solar-pwr/usb-pmt/production/bom-for-jlcpcb.xls

Comment | Designator | Footprint | JLCPCB Part # | Qty | Ext.Price($)
TL431DBZ | U2 | SOT-23 | C6971 | 5 | 0.82
1uF | C22 | 0805 | C28323 | 5 | 0.15
4.7nF/2kV | C1,C2,C3,C9 | 1812 | C309511 | 22 | 3.72
MMBT2222A | Q2,Q3 | SOT-23 | C8512 | 10 | 0.18
1R | R32 | 0603 | C22936 | 5 | 0.01
CM108B | IC1 | LQFP-48_7x7mm_P0.5mm | C371347 | 5 | 17.91
10M/200V | R10,R11,R12,R3,R4,R5,R6,R7,R8,R9 | 1206 | C26119 | 54 | 0.30
100pF | C23,C24 | 0603 | C14858 | 10 | 0.09
PWR | D8 | 0805 | C84256 | 5 | 0.07
22k | R24,R25 | 0603 | C31850 | 10 | 0.04
LEDO | D7 | 0805 | C2297 | 5 | 0.08
82k | R14 | 0603 | C23254 | 5 | 0.01
10uF | C19 | 0603 | C19702 | 5 | 0.14
LM393 | U3 | SOIC-8_3.9x4.9mm_P1.27mm | C7955 | 5 | 0.33
10uF | C14,C15,C16,C17,C18,C20,C25,C28 | 0805 | C15850 | 40 | 1.70
US1M | D1,D2,D3,D4 | D_SMA | C412437 | 20 | 0.27
22R | R34,R35 | 0603 | C23345 | 10 | 0.02
47nF/2kV | C6,C8 | 2225 | C2936147 | 10 | 4.79
5k1 | R15,R39,R40 | 0603 | C23186 | 15 | 0.02
1R | R30,R31 | 1206 | C17928 | 10 | 0.23
IPN80R2K0P7 | Q1 | SOT-223-3_TabPin2 | C537101 | 5 | 1.91
1M/200V | R19,R20,R21,R22,R23 | 1206 | C17927 | 25 | 0.11
51k | R17,R18 | 0603 | C23196 | 10 | 0.02
100nF | C13,C21,C26,C27 | 0805 | C28233 | 20 | 0.49
150pF | C10 | 0603 | C1594 | 5 | 0.03
330pF | C4 | 0603 | C1664 | 5 | 0.09
USB-C | J2 | USB_C_Receptacle_GCT_USB4105-xx-A_16P_TopMnt_Horizontal | C5150972 | 5 | 3.70
1M | R26 | 0603 | C22935 | 5 | 0.01
1N4148W | D5 | D_SOD-123 | C81598 | 5 | 0.06
10k | R27 | 0603 | C25804 | 5 | 0.01
1k | R2,R28,R29 | 0603 | C21190 | 15 | 0.03
LEDR | D6 | 0805 | C34499 | 5 | 0.10
100k | R13,R16 | 0603 | C25803 | 10 | 0.03
100nF | C5 | 0603 | C14663 | 5 | 0.04
470k | R1 | 0603 | C23178 | 5 | 0.02
4.7nF | C11,C12 | 0603 | C53987 | 10 | 0.06
2k2 | R36,R37,R38 | 0603 | C4190 | 15 | 0.03
74HC14 | U1 | SOIC-14_3.9x8.7mm_P1.27mm | C5605 | 5 | 0.39
