solar-pwr/usb-pmt/production/bom.csv

Designator | Footprint | Quantity | Value | LCSC Part #
C1, C2, C3, C9 | 1812 | 4 | 4.7nF/2kV
C10 | 0603 | 1 | 150pF
C11, C12 | 0603 | 2 | 4.7nF
C13, C21, C26, C27 | 0805 | 4 | 100nF
C14, C15, C16, C17, C20, C25 | 0805 | 6 | 10uF
C18, C28 | 0805 | 2 | 22uF | CL21A226MAQNNNE
C19 | 0603 | 1 | 10uF
C22 | 0805 | 1 | 1uF
C23, C24 | 0603 | 2 | 100pF
C29, C7 | CP_Radial_D8.0mm_P3.50mm | 2 | 1mF/16V
C4 | 0603 | 1 | 330pF
C5 | 0603 | 1 | 100nF
C6, C8 | 2225 | 2 | 47nF/2kV
D1, D2, D3, D4 | D_SMA | 4 | US1M
D5 | D_SOD-123 | 1 | 1N4148W
D6 | 0805 | 1 | LEDR
D7 | 0805 | 1 | LEDO
D8 | 0805 | 1 | PWR
IC1 | LQFP-48_7x7mm_P0.5mm | 1 | CM108B
J1 | LEMO-EPL.00.250.NTN+RSMA | 1 | LEMO/RSMA
J2 | USB_C_Receptacle_GCT_USB4105-xx-A_16P_TopMnt_Horizontal | 1 | USB-C
L1 | L_Radial_D12.0mm_P5.00mm_Fastron_11P | 1 | 3.3mH
L2 | L_Radial_D12.0mm_P5.00mm_Fastron_11P | 1 | 1mH
Q1 | SOT-223-3_TabPin2 | 1 | IPN80R2K0P7
Q2, Q3 | SOT-23 | 2 | MMBT2222A
R1 | 0603 | 1 | 470k
R10, R11, R12, R3, R4, R5, R6, R7, R8, R9 | 1206 | 10 | 10M/200V
R13, R16 | 0603 | 2 | 100k
R14 | 0603 | 1 | 82k
R15, R39, R40 | 0603 | 3 | 5k1
R17, R18 | 0603 | 2 | 51k
R19, R20, R21, R22, R23 | 1206 | 5 | 1M/200V
R2, R28, R29 | 0603 | 3 | 1k
R24, R25 | 0603 | 2 | 22k
R26 | 0603 | 1 | 1M
R27 | 0603 | 1 | 10k
R30, R31 | 1206 | 2 | 1R
R32 | 0603 | 1 | 1R
R34, R35 | 0603 | 2 | 22R
R36, R37, R38 | 0603 | 3 | 2k2
RV1 | Potentiometer_Bourns_3006P_Horizontal | 1 | 500k
TP1 | PinHeader_1x01_P2.54mm_Vertical | 1 | PMT+
TP2 | PinHeader_1x01_P2.54mm_Vertical | 1 | PMT-
U1 | SOIC-14_3.9x8.7mm_P1.27mm | 1 | 74HC14
U2 | SOT-23 | 1 | TL431DBZ
U3 | SOIC-8_3.9x4.9mm_P1.27mm | 1 | LM393
U4 | DIP-8_W7.62mm_Socket_LongPads | 1 | 93C46B
