solar-pwr/usb-pmt/usb-pmt.pdf

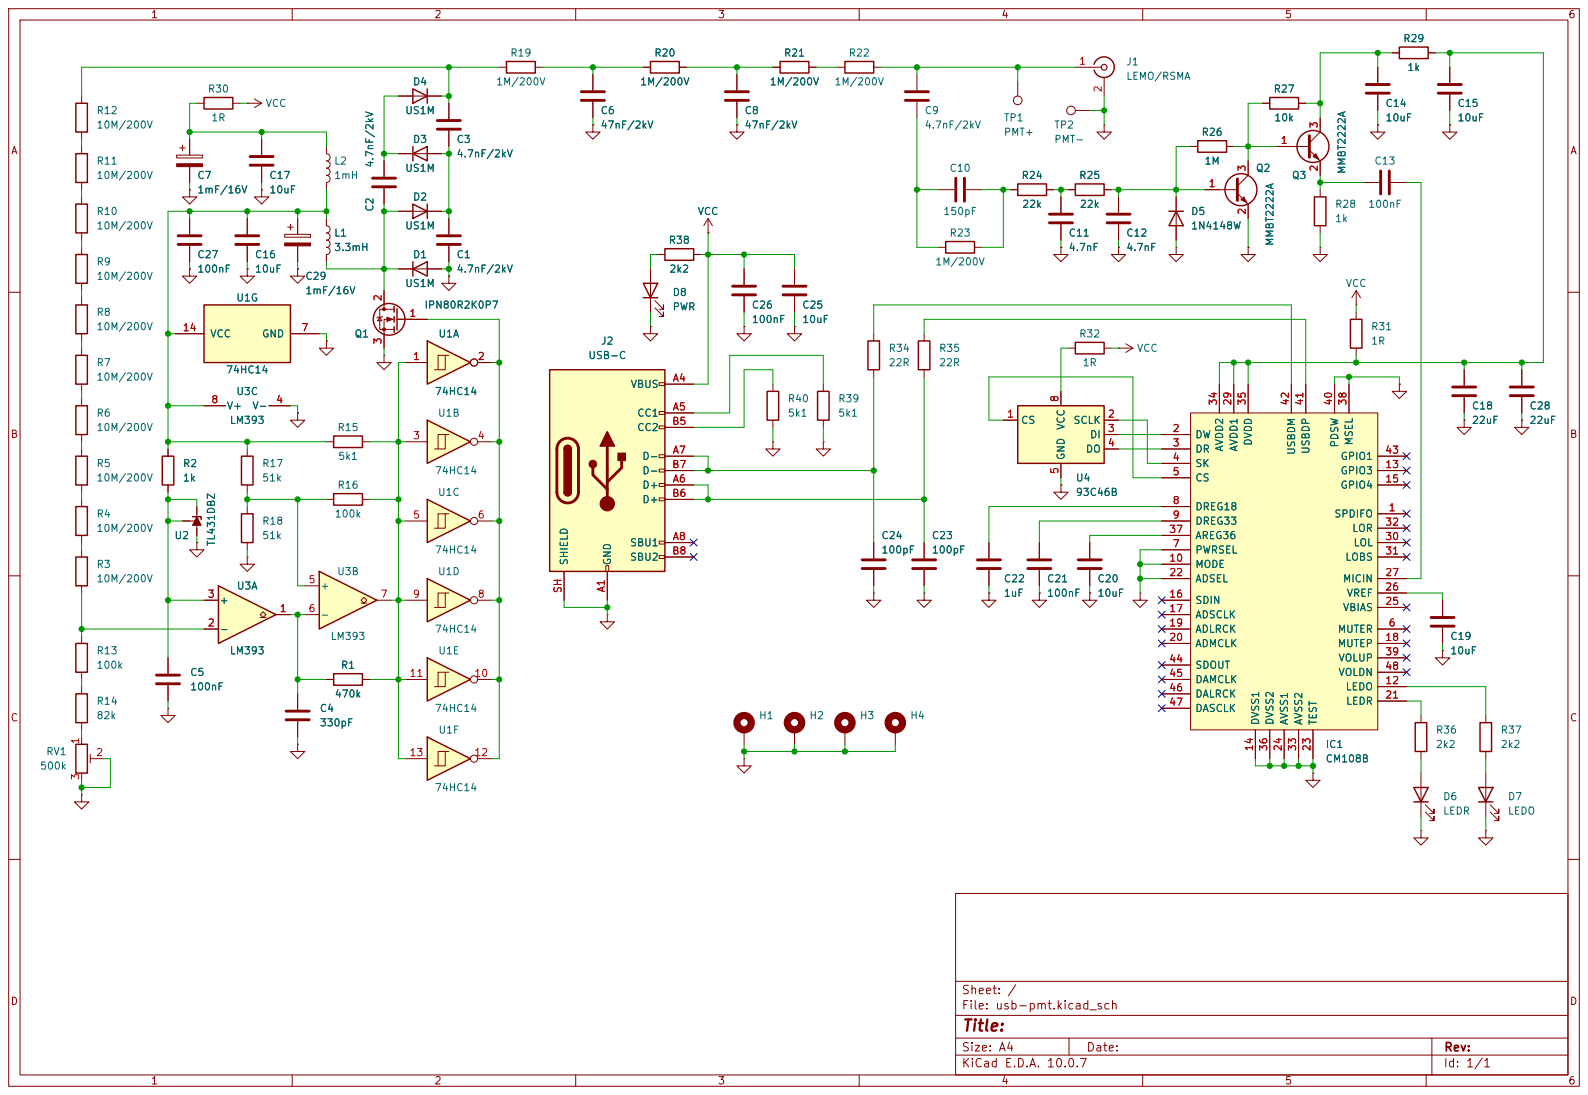
[picture p1: page 1]

Size: A4 | Rev:
KiCad E.D.A. 10.0.7 | Id: 1/1
