solar-pwr/usb-pmt/usb-pmt.kicad_pcb

## KiCad design usb-pmt.kicad_pcb (2026-10-22)

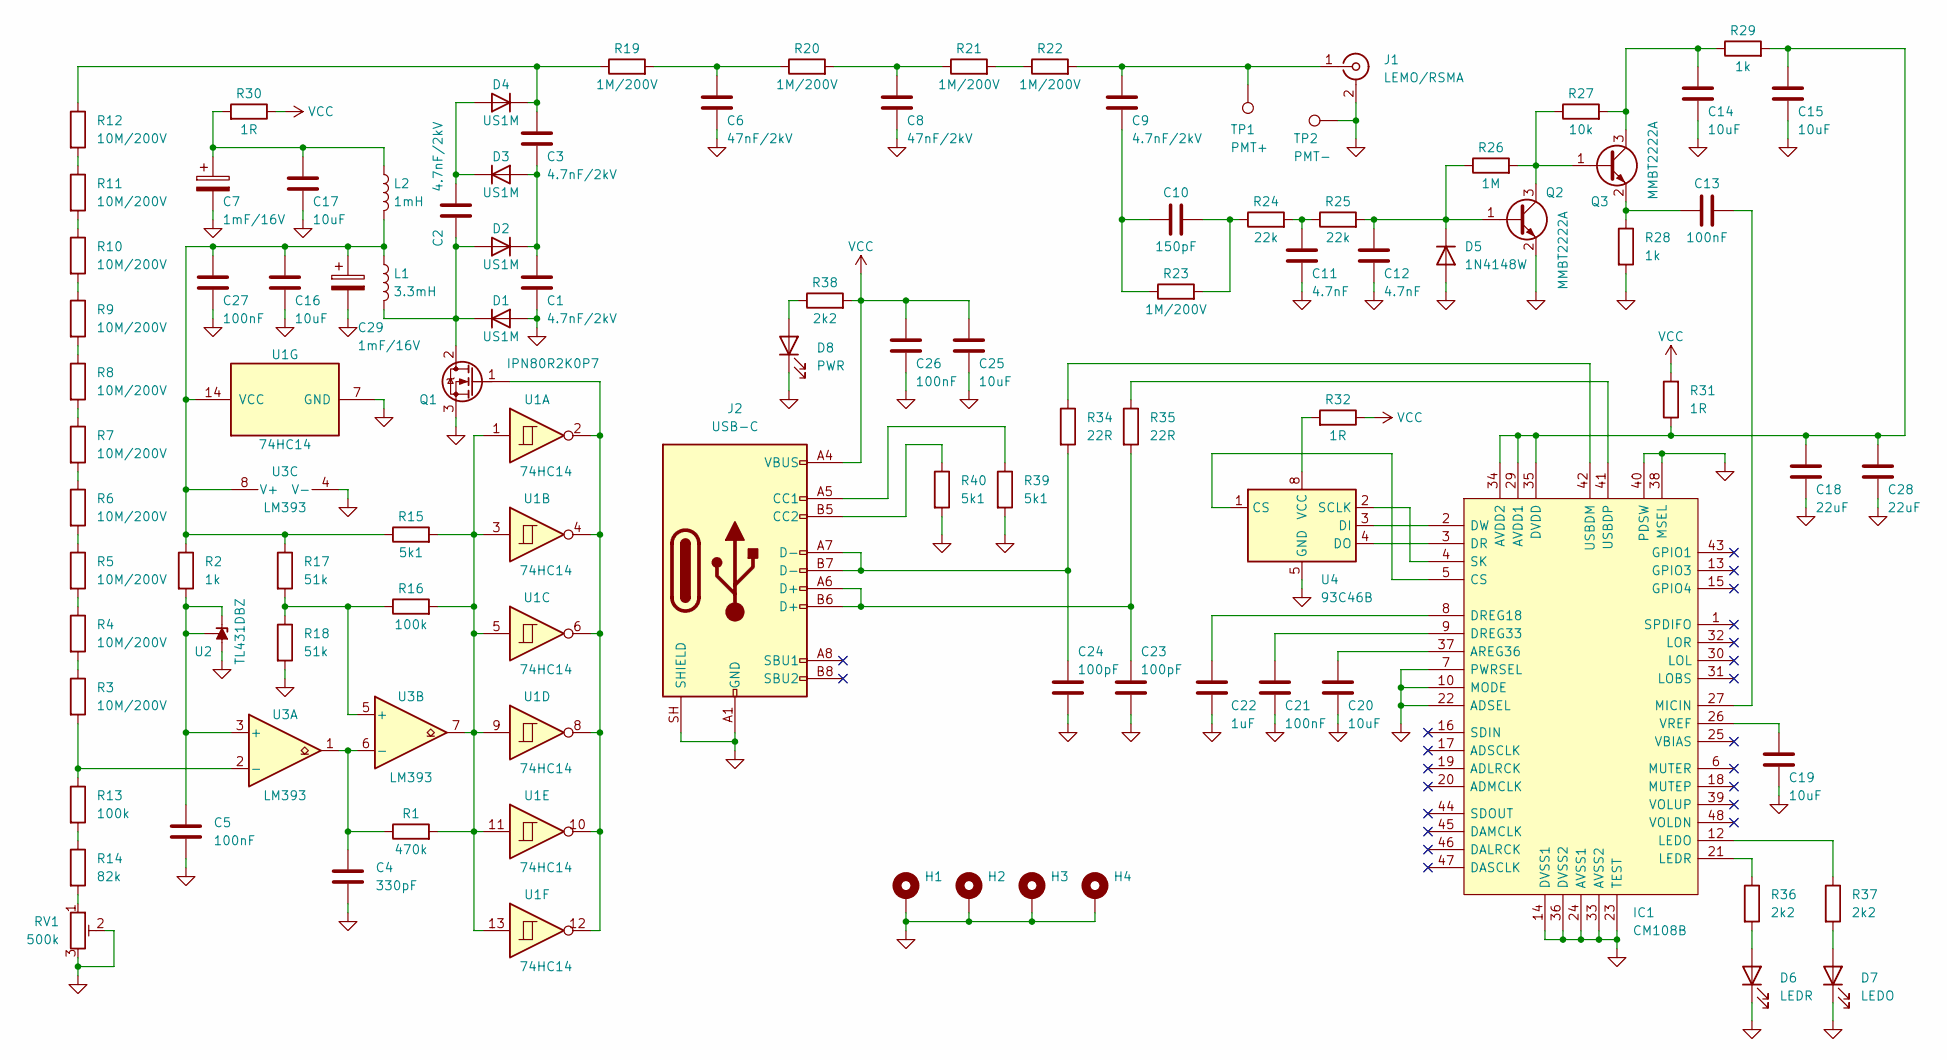
[picture p2: schematic usb-pmt.kicad_sch]

Parts:
C1, C2, C3, C9: 4.7nF/2kV; C_1812_4532Metric
C4: 330pF; C_0603_1608Metric
C5: 100nF; C_0603_1608Metric
C6, C8: 47nF/2kV; C_2225_5664Metric
C7, C29: 1mF/16V; CP_Radial_D8.0mm_P3.50mm
C10: 150pF; C_0603_1608Metric
C11, C12: 4.7nF; C_0603_1608Metric
C13, C21, C26, C27: 100nF; C_0805_2012Metric
C14, C15, C16, C17, C20, C25: 10uF; C_0805_2012Metric
C18, C28: 22uF; C_0805_2012Metric; LCSC CL21A226MAQNNNE
C19: 10uF; C_0603_1608Metric
C22: 1uF; C_0805_2012Metric
C23, C24: 100pF; C_0603_1608Metric
D1, D2, D3, D4: US1M; D_SMA
D5: 1N4148W; D_SOD-123
D6: LEDR; LED_0805_2012Metric
D7: LEDO; LED_0805_2012Metric
D8: PWR; LED_0805_2012Metric
H1, H2, H3, H4: MountingHole_Pad; MountingHole_3.2mm_M3_DIN965_Pad
IC1: CM108B; LQFP-48_7x7mm_P0.5mm; Manufacturer_Part_Number CM108
J1: LEMO/RSMA; LEMO-EPL.00.250.NTN+RSMA
J2: USB-C; USB_C_Receptacle_GCT_USB4105-xx-A_16P_TopMnt_Horizontal
L1: 3.3mH; L_Radial_D12.0mm_P5.00mm_Fastron_11P
L2: 1mH; L_Radial_D12.0mm_P5.00mm_Fastron_11P
Q1: IPN80R2K0P7; SOT-223-3_TabPin2
Q2, Q3: MMBT2222A; SOT-23
R1: 470k; R_0603_1608Metric
R2, R28, R29: 1k; R_0603_1608Metric
R3, R4, R5, R6, R7, R8, R9, R10, R11, R12: 10M/200V; R_1206_3216Metric
R13, R16: 100k; R_0603_1608Metric
R14: 82k; R_0603_1608Metric
R15, R39, R40: 5k1; R_0603_1608Metric
R17, R18: 51k; R_0603_1608Metric
R19, R20, R21, R22, R23: 1M/200V; R_1206_3216Metric
R24, R25: 22k; R_0603_1608Metric
R26: 1M; R_0603_1608Metric
R27: 10k; R_0603_1608Metric
R30, R31: 1R; R_1206_3216Metric
R32: 1R; R_0603_1608Metric
R34, R35: 22R; R_0603_1608Metric
R36, R37, R38: 2k2; R_0603_1608Metric
RV1: 500k; Potentiometer_Bourns_3006P_Horizontal
TP1: PMT+; PinHeader_1x01_P2.54mm_Vertical
TP2: PMT-; PinHeader_1x01_P2.54mm_Vertical
U1: 74HC14; SOIC-14_3.9x8.7mm_P1.27mm
U2: TL431DBZ; SOT-23
U3: LM393; SOIC-8_3.9x4.9mm_P1.27mm
U4: 93C46B; DIP-8_W7.62mm_Socket_LongPads

Connections:
GND: C1.1, C4.1, C5.1, C6.1, C7.2, C8.1, C11.2, C12.2, C14.2, C15.2, C16.2, C17.2, C18.2, C19.2, C20.2, C21.2, C22.2, C23.2, C24.2, C25.2, C26.2, C27.2, C28.2, C29.2, D1.2 (A), D5.2 (A), D6.1 (K), D7.1 (K), D8.1 (K), H1.1 (1_1), H2.1 (1_1), H3.1 (1_1), H4.1 (1_1), IC1.7 (PWRSEL), IC1.10 (MODE), IC1.14 (DVSS1), IC1.22 (ADSEL), IC1.23 (TEST), IC1.24 (AVSS1), IC1.33 (AVSS2), IC1.36 (DVSS2), IC1.38 (MSEL), IC1.40 (PDSW), J1.2 (Ext), J2.A1 (GND), J2.A12 (GND), J2.B1 (GND), J2.B12 (GND), J2.SH (SHIELD), Q1.3 (S), Q2.2 (E), R18.2, R28.2, R39.2, R40.2, RV1.2, RV1.3, TP2.1 (1_1), U1.7 (GND), U2.3 (A), U3.4 (V-), U4.5 (GND)
unnamed: C6.2, R19.2, R20.1
unnamed: C8.2, R20.2, R21.1
unnamed: C9.1, C10.1, R23.1
unnamed: C10.2, R23.2, R24.1
unnamed: C11.1, R24.2, R25.1
unnamed: C7.1, C17.1, L2.1, R30.2
unnamed: C23.1, J2.A6 (D+), J2.B6 (D+), R35.2
unnamed: C24.1, J2.A7 (D-), J2.B7 (D-), R34.2
unnamed: C2.1, D1.1 (K), D2.2 (A), L1.2, Q1.2 (D)
unnamed: C1.2, C3.1, D2.1 (K), D3.2 (A)
unnamed: C2.2, D3.1 (K), D4.2 (A)
unnamed: C3.2, D4.1 (K), R12.1, R19.1
unnamed: C12.1, D5.1 (K), Q2.1 (B), R25.2, R26.1
unnamed: D6.2 (A), R36.2
unnamed: D7.2 (A), R37.2
unnamed: D8.2 (A), R38.1
unnamed: C20.1, IC1.37 (AREG36)
unnamed: C15.1, C18.1, C28.1, IC1.29 (AVDD1), IC1.34 (AVDD2), IC1.35 (DVDD), R29.2, R31.1
unnamed: IC1.5 (CS), U4.1 (CS)
unnamed: IC1.3 (DR), U4.4 (DO)
unnamed: C22.1, IC1.8 (DREG18)
unnamed: C21.1, IC1.9 (DREG33)
unnamed: IC1.2 (DW), U4.3 (DI)
unnamed: IC1.12 (LEDO), R37.1
unnamed: IC1.21 (LEDR), R36.1
unnamed: C13.2, IC1.27 (MICIN)
unnamed: IC1.4 (SK), U4.2 (SCLK)
unnamed: IC1.42 (USBDM), R34.1
unnamed: IC1.41 (USBDP), R35.1
unnamed: C19.1, IC1.26 (VREF)
unnamed: C9.2, J1.1 (In), R22.2, TP1.1 (1_1)
unnamed: J2.A5 (CC1), R39.1
unnamed: J2.B5 (CC2), R40.1
unnamed: Q1.1 (G), U1.2, U1.4, U1.6, U1.8, U1.10, U1.12
unnamed: Q2.3 (C), Q3.1 (B), R26.2, R27.1
unnamed: C14.1, Q3.3 (C), R27.2, R29.1
unnamed: C13.1, Q3.2 (E), R28.1
unnamed: R1.2, R15.2, R16.2, U1.1, U1.3, U1.5, U1.9, U1.11, U1.13, U3.7
unnamed: R3.1, R4.2
unnamed: R4.1, R5.2
unnamed: R5.1, R6.2
unnamed: R6.1, R7.2
unnamed: R7.1, R8.2
unnamed: R8.1, R9.2
unnamed: R10.1, R11.2
unnamed: R9.1, R10.2
unnamed: R11.1, R12.2
unnamed: R13.2, R14.1
unnamed: R14.2, RV1.1
unnamed: R21.2, R22.1
unnamed: C16.1, C27.1, C29.1, L1.1, L2.2, R2.1, R15.1, R17.1, U1.14 (VCC), U3.8 (V+)
unnamed: C5.2, R2.2, U2.1 (K), U2.2 (REF), U3.3 (+)
unnamed: R3.2, R13.1, U3.2 (-)
unnamed: R16.1, R17.2, R18.1, U3.5 (+)
unnamed: C4.2, R1.1, U3.1, U3.6 (-)
unnamed: R32.2, U4.8 (VCC)
VCC: C25.1, C26.1, J2.A4 (VBUS), J2.A9 (VBUS), J2.B4 (VBUS), J2.B9 (VBUS), R30.1, R31.2, R32.1, R38.2

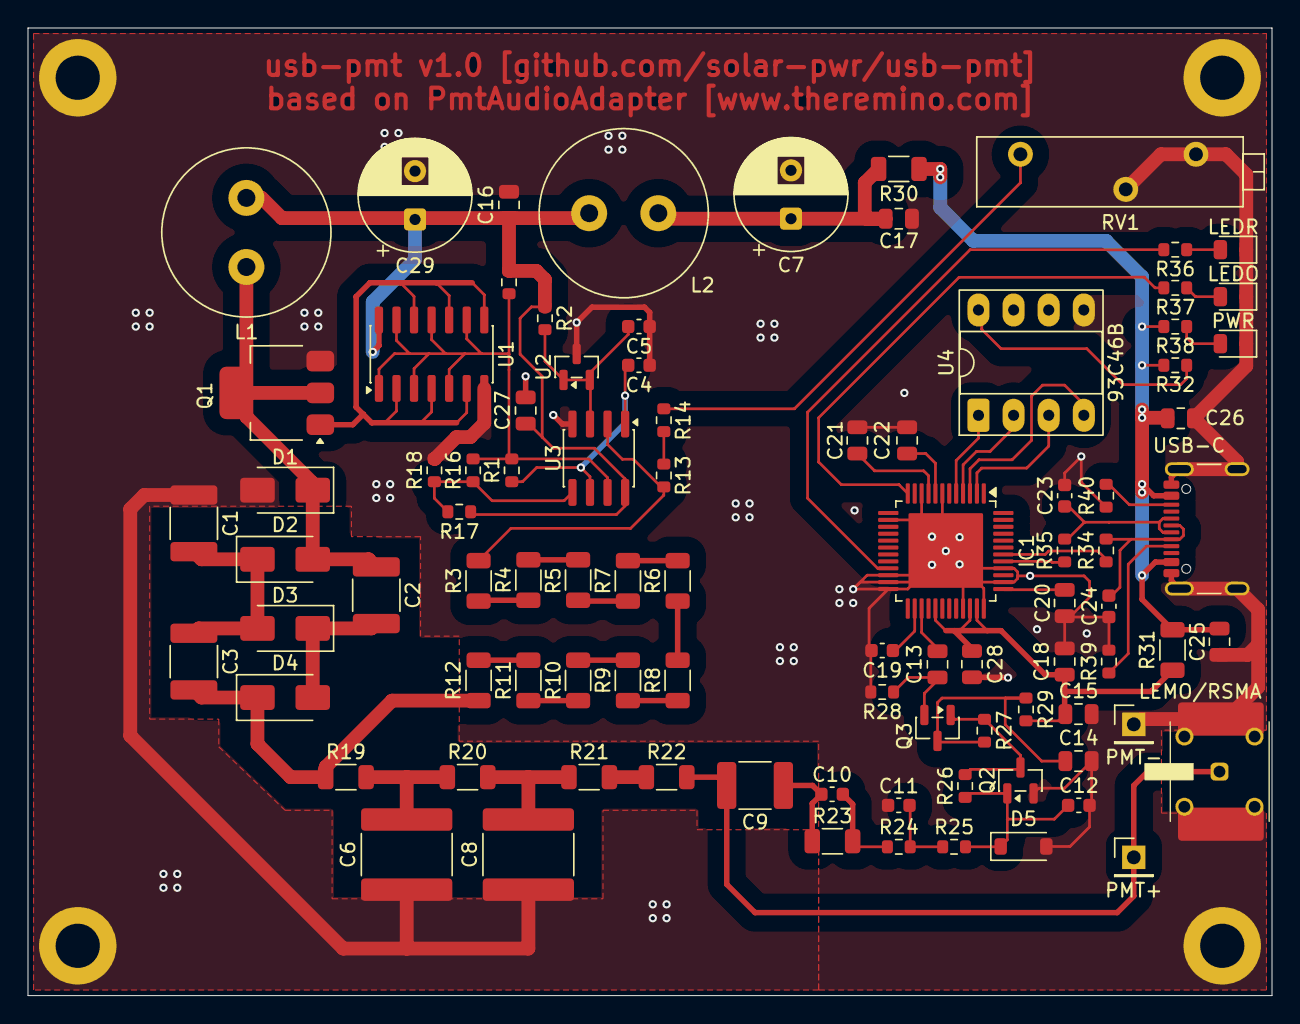
[picture p3: board usb-pmt.kicad_pcb from above]

Board: 2 copper layers, 90.0 x 70.0 mm, 95 parts (0 on the bottom side), 58 nets.
