solar-pwr/usb-pmt/(commit log)

2026-11-07 Add known bugs section for v1.0
    Added known bugs section for version 1.0 with details on power supply limitations, filtering capacitance, and LED glare issues.
2026-11-10 Update known bugs section in README.md
    Added note about pole-zero cancellation resistor for C13.
